genzma/Lidar/Schematic Lidar Final.pdf

+5V

+15V

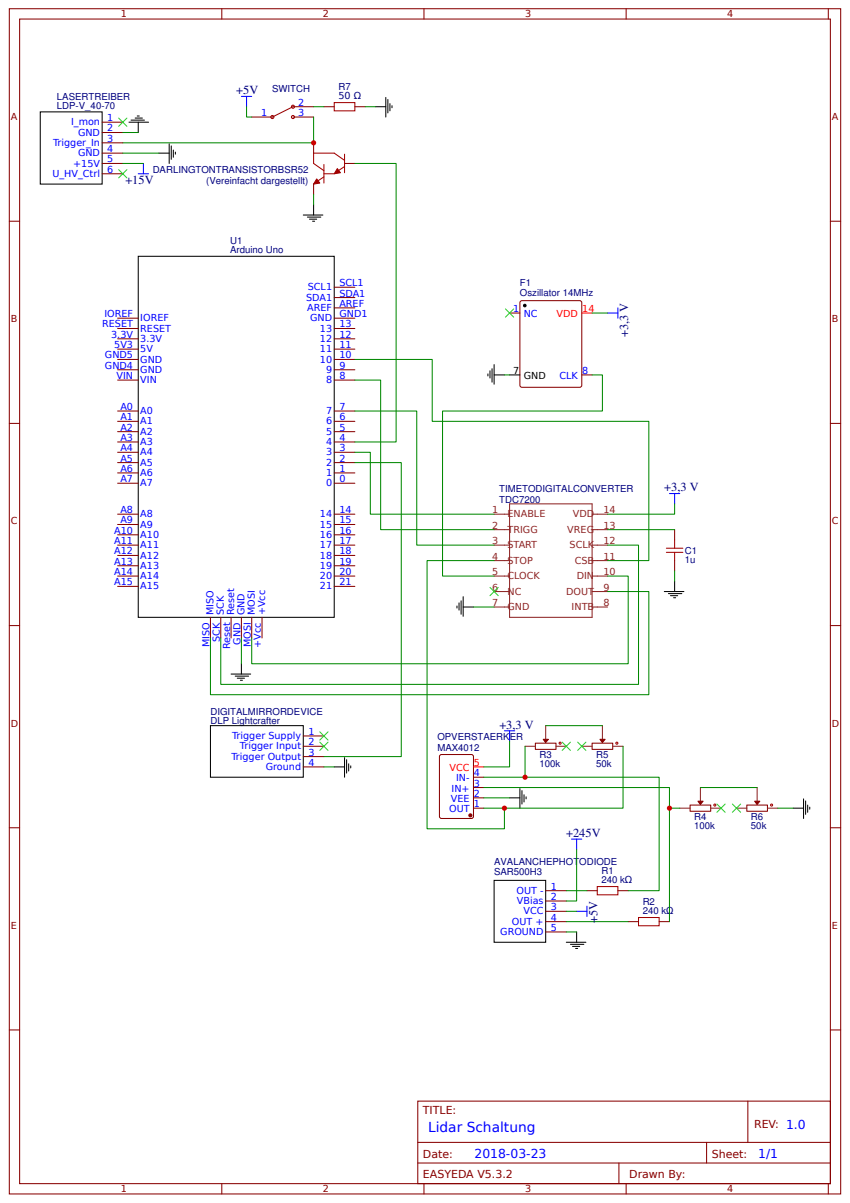
[picture p1: page 1]

VIN VIN GND GND4 GND GND5 5V 5V3 3.3V 3.3V RESET RESET IOREF IOREF

Reset Reset SCK SCK

OPVERSTAERKER
MAX4012
OUT 1 VEE 2 IN+ 3 IN- 4 VCC 5
